IldusV/lighting_controller/README.md

# Lighting Controller Project

This project controls lights via Mqtt

## Preview

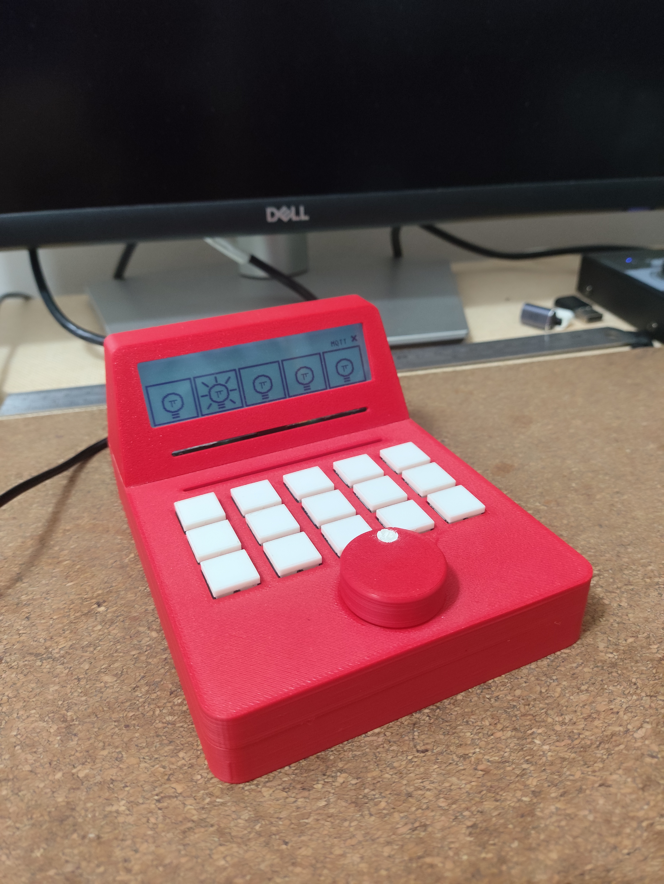
[picture p1: Documents/lighting_controller.jpg]
Lighting Controller


---

## Description
