IldusV/lighting_controller/Documents/README.md

# Lighting Controller Project

This project controls lights via Mqtt

## Preview

Lighting Controller

---

## Description
