IldusV/lighting_controller/Documents/JLX25664G-580_I2C_display_interface_CN.png

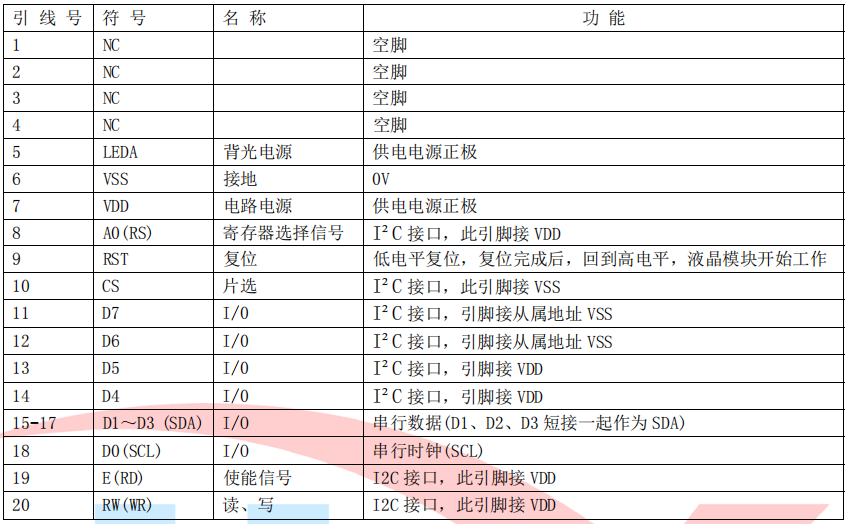
Documents/JLX25664G-580_I2C_display_interface_CN.png
