IldusV/lighting_controller/PCB/keypad/releases/lighting_keypad_schematic_rev_B.pdf

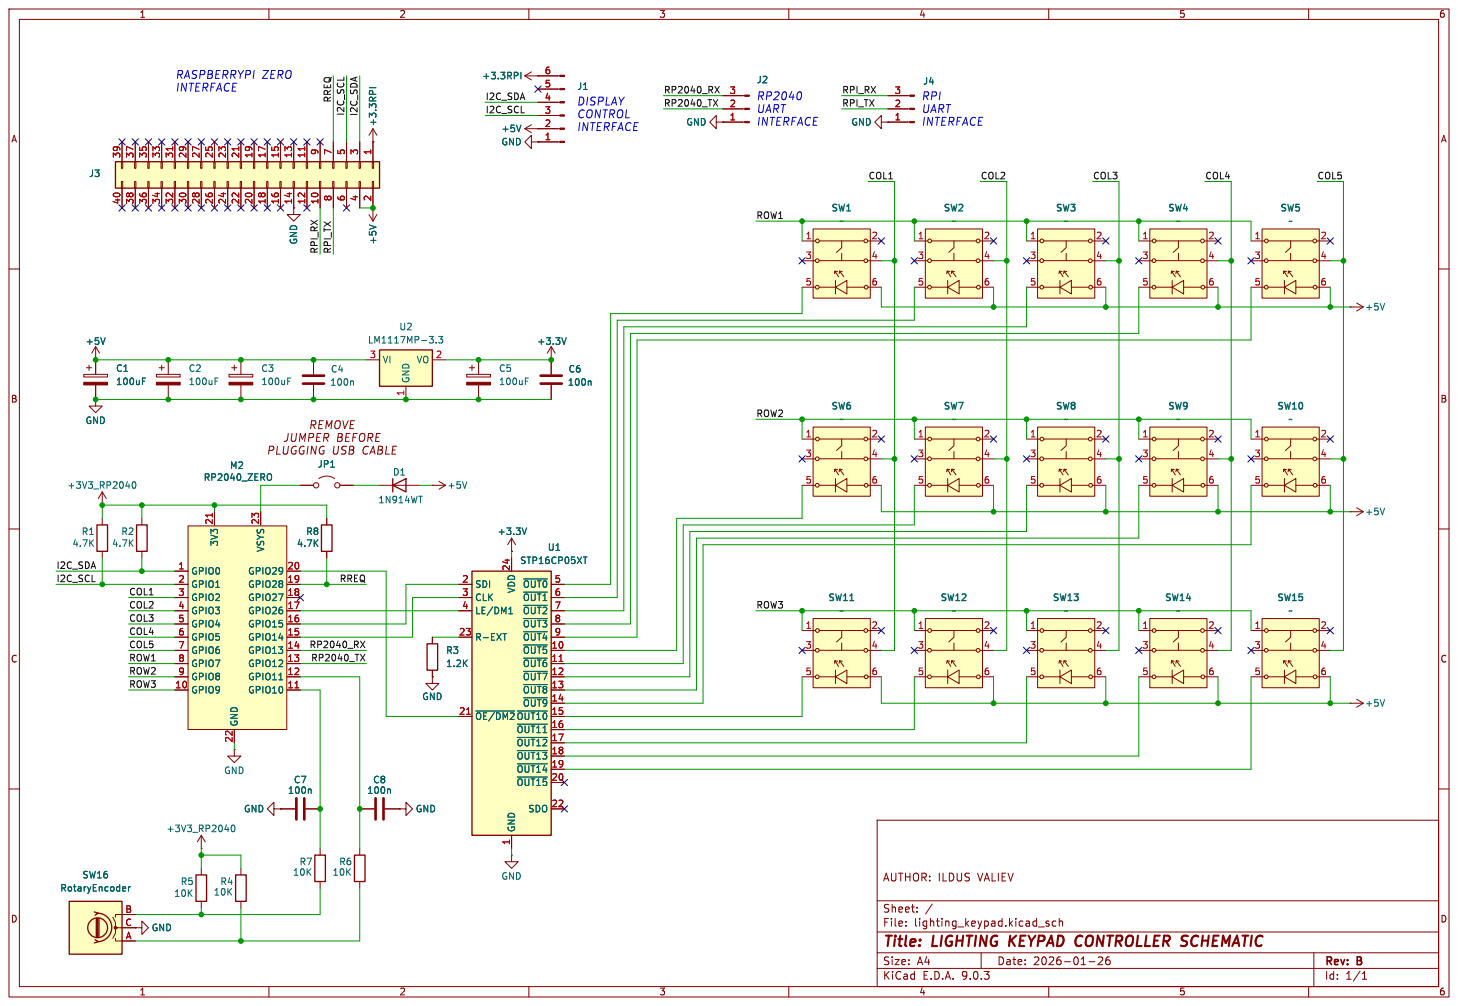
[picture p4: page 1]

File: lighting_keypad.kicad_sch Sheet: / AUTHOR: ILDUS VALIEV

Id: 1/1 Title: LIGHTING KEYPAD CONTROLLER SCHEMATIC
