IldusV/lighting_controller/PCB/keypad/lighting_keypad.kicad_pcb

## KiCad design PCB/keypad/lighting_keypad.kicad_pcb (2026-02-06)

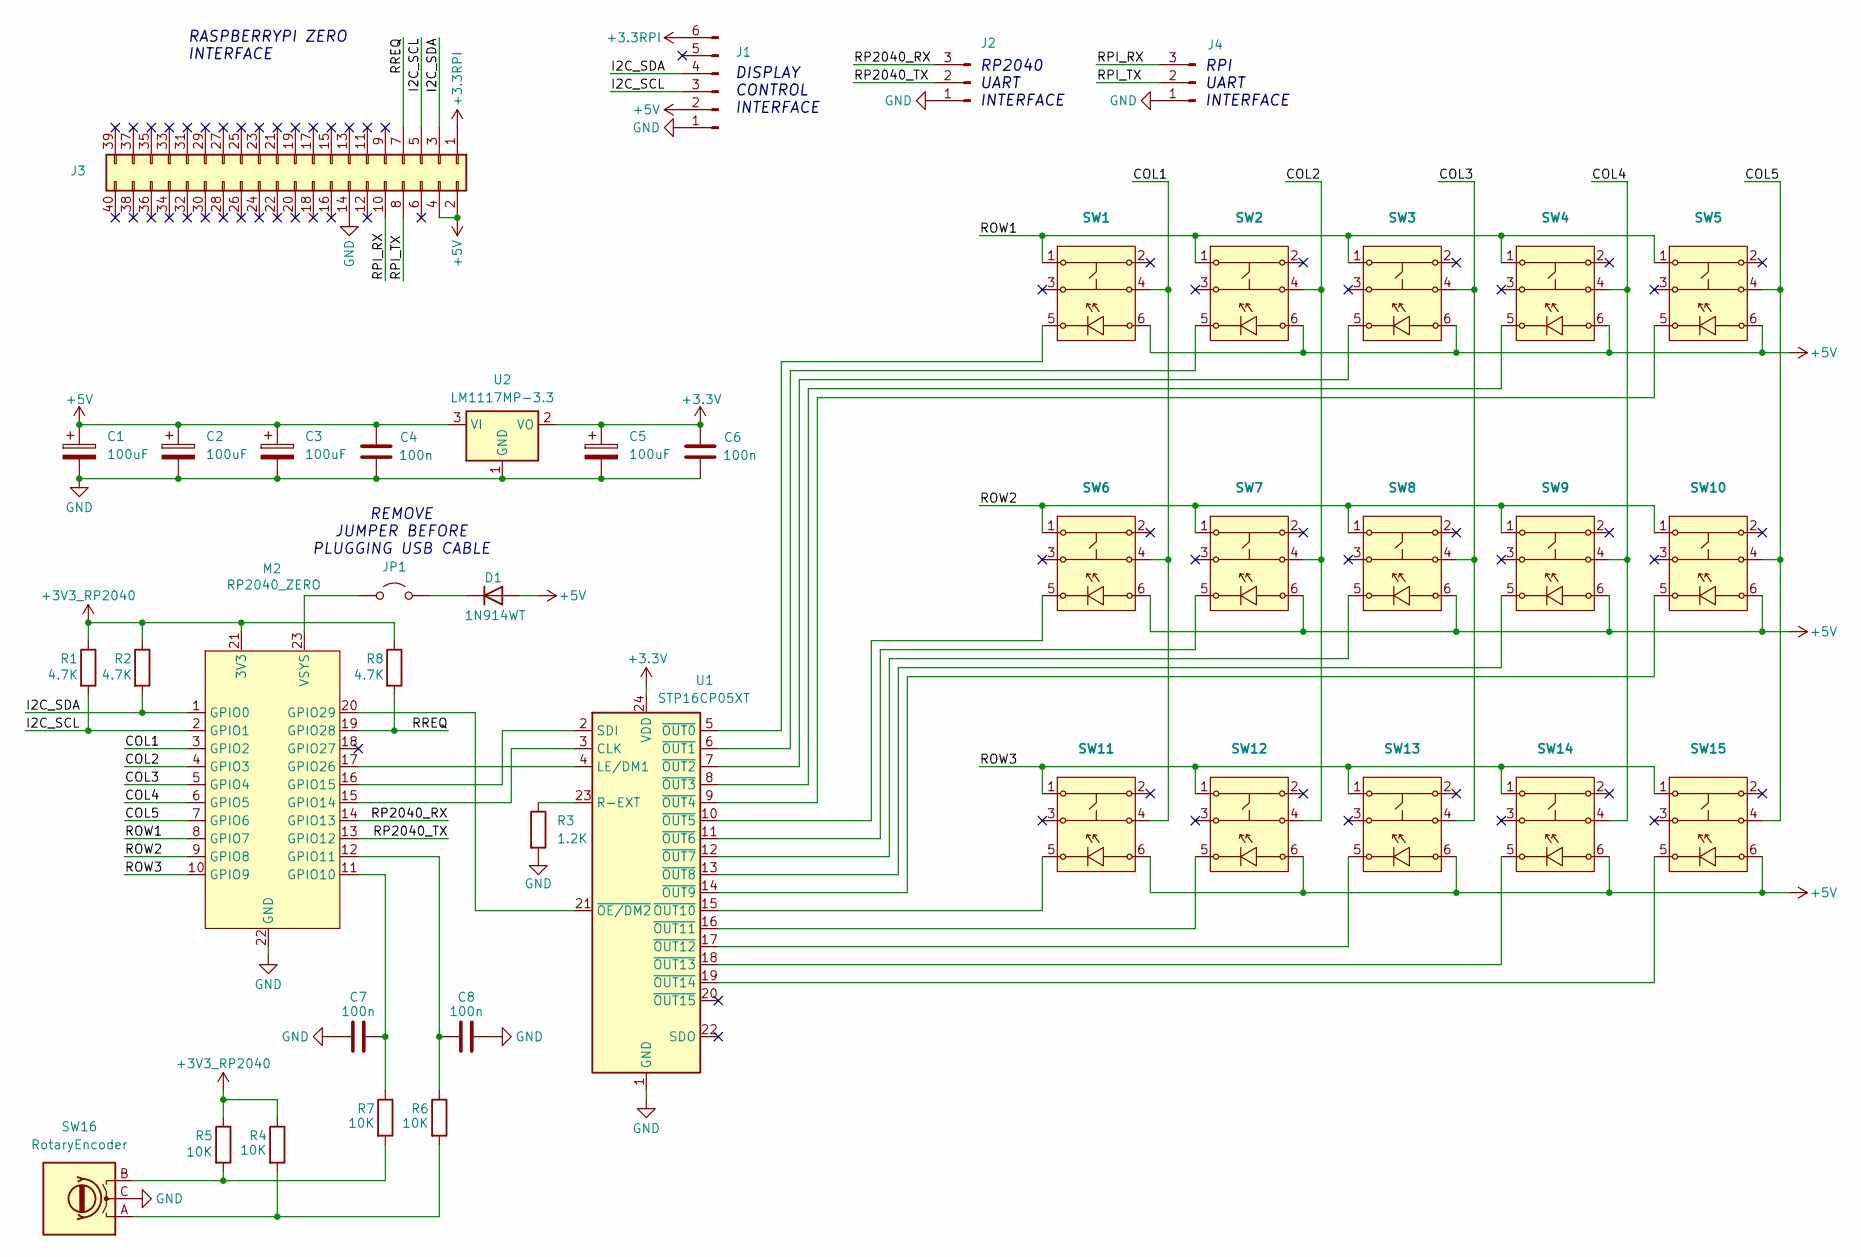
[picture p5: schematic lighting_keypad.kicad_sch, LIGHTING KEYPAD CONTROLLER SCHEMATIC]

Parts:
C1, C2, C3, C5: 100uF; CP_EIA-7343-30_AVX-N_Pad2.25x2.55mm_HandSolder
C4, C6, C7, C8: 100n; C_0603_1608Metric_Pad1.08x0.95mm_HandSolder
D1: 1N914WT; D_SOD-523
J1: Conn_01x06_Pin; PinHeader_1x06_P2.54mm_Vertical
J2, J4: Conn_01x03_Pin; PinHeader_1x03_P2.54mm_Vertical
J3: Conn_02x20_Odd_Even; raspberry_pi_zero_outline
JP1: Jumper_2_Open; PinHeader_1x02_P2.54mm_Vertical
M2: RP2040_ZERO; RP2040-Zero
R1, R2, R8: 4.7K; R_0603_1608Metric_Pad0.98x0.95mm_HandSolder
R3: 1.2K; R_0603_1608Metric_Pad0.98x0.95mm_HandSolder
R4, R5, R6, R7: 10K; R_0603_1608Metric_Pad0.98x0.95mm_HandSolder
SW1, SW2, SW3, SW4, SW5, SW6, SW7, SW8, SW9, SW10, SW11, SW12, SW13, SW14, SW15: Honyone_TS12
SW16: RotaryEncoder; RotaryEncoder_Alps_EC12E_Vertical_H20mm_CircularMountingHol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
U1: STP16CP05XT; SOIC127P1032X265-24N
U2: LM1117MP-3.3; SOT-223-3_TabPin2

Connections:
+3.3RPI: J1.6, J3.1
+3.3V: C5.1, C6.1, U1.24 (VDD), U2.2 (VO)
+3V3_RP2040: M2.21 (3V3), R1.1, R2.1, R4.1, R5.1, R8.1
+5V: C1.1, C2.1, C3.1, C4.1, D1.2 (A), J1.2, J3.2, J3.4, SW1.6, SW2.6, SW3.6, SW4.6, SW5.6, SW6.6, SW7.6, SW8.6, SW9.6, SW10.6, SW11.6, SW12.6, SW13.6, SW14.6, SW15.6, U2.3 (VI)
/COL1: M2.3 (GPIO2), SW1.4, SW6.4, SW11.4
/COL2: M2.4 (GPIO3), SW2.4, SW7.4, SW12.4
/COL3: M2.5 (GPIO4), SW3.4, SW8.4, SW13.4
/COL4: M2.6 (GPIO5), SW4.4, SW9.4, SW14.4
/COL5: M2.7 (GPIO6), SW5.4, SW10.4, SW15.4
/I2C_SCL: J1.3, J3.5, M2.2 (GPIO1), R1.2
/I2C_SDA: J1.4, J3.3, M2.1 (GPIO0), R2.2
/ROW1: M2.8 (GPIO7), SW1.1, SW2.1, SW3.1, SW4.1, SW5.1
/ROW2: M2.9 (GPIO8), SW6.1, SW7.1, SW8.1, SW9.1, SW10.1
/ROW3: M2.10 (GPIO9), SW11.1, SW12.1, SW13.1, SW14.1, SW15.1
/RP2040_RX: J2.3, M2.14 (GPIO13)
/RP2040_TX: J2.2, M2.13 (GPIO12)
/RPI_RX: J3.10, J4.3
/RPI_TX: J3.8, J4.2
/RREQ: J3.7, M2.19 (GPIO28), R8.2
GND: C1.2, C2.2, C3.2, C4.2, C5.2, C6.2, C7.2, C8.1, J1.1, J2.1, J3.14, J4.1, M2.22 (GND), R3.2, SW16.C, U1.1 (GND), U1.25 (GND), U2.1 (GND)
unnamed: D1.1 (K), JP1.2 (B)
unnamed: JP1.1 (A), M2.23 (VSYS)
unnamed: C7.1, M2.11 (GPIO10), R7.1
unnamed: C8.2, M2.12 (GPIO11), R6.1
unnamed: M2.15 (GPIO14), U1.3 (CLK)
unnamed: M2.16 (GPIO15), U1.2 (SDI)
unnamed: M2.17 (GPIO26), U1.4 (LE/DM1)
unnamed: M2.20 (GPIO29), U1.21 (~OE/DM2)
unnamed: R4.2, R6.2, SW16.A
unnamed: R5.2, R7.2, SW16.B
unnamed: R3.1, U1.23 (R-EXT)
unnamed: SW1.5, U1.5 (~OUT0)
unnamed: SW2.5, U1.6 (~OUT1)
unnamed: SW3.5, U1.7 (~OUT2)
unnamed: SW4.5, U1.8 (~OUT3)
unnamed: SW5.5, U1.9 (~OUT4)
unnamed: SW6.5, U1.10 (~OUT5)
unnamed: SW7.5, U1.11 (~OUT6)
unnamed: SW8.5, U1.12 (~OUT7)
unnamed: SW9.5, U1.13 (~OUT8)
unnamed: SW10.5, U1.14 (~OUT9)
unnamed: SW11.5, U1.15 (~OUT10)
unnamed: SW12.5, U1.16 (~OUT11)
unnamed: SW13.5, U1.17 (~OUT12)
unnamed: SW14.5, U1.18 (~OUT13)
unnamed: SW15.5, U1.19 (~OUT14)

Notes on the sheet:
DISPLAY CONTROL INTERFACE
REMOVE JUMPER BEFORE PLUGGING USB CABLE
RPI UART INTERFACE
RP2040 UART INTERFACE
RASPBERRYPI ZERO INTERFACE

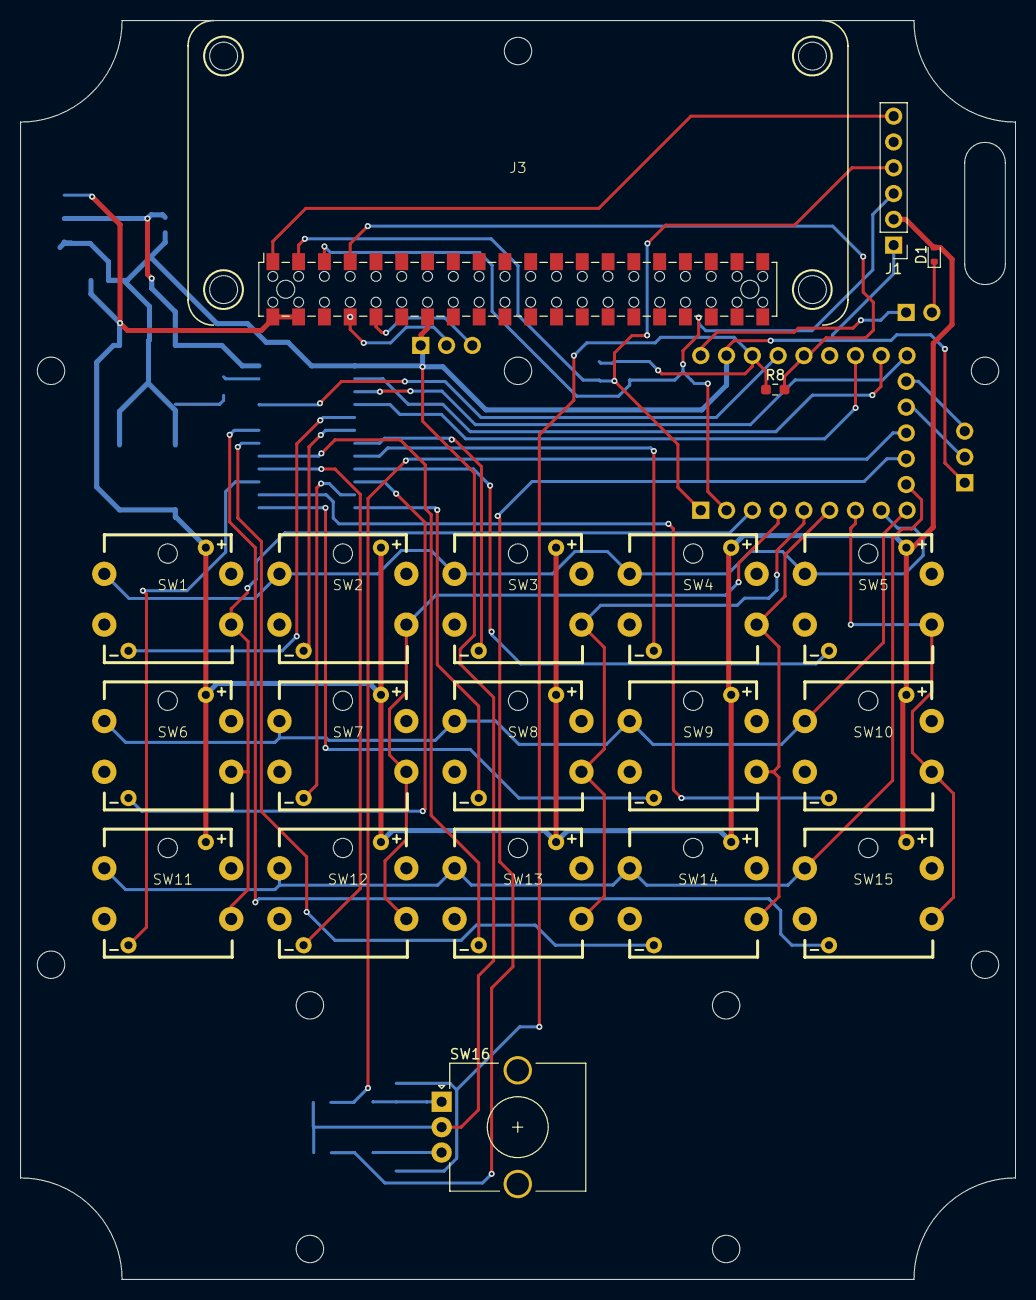
[picture p6: board lighting_keypad.kicad_pcb from above]

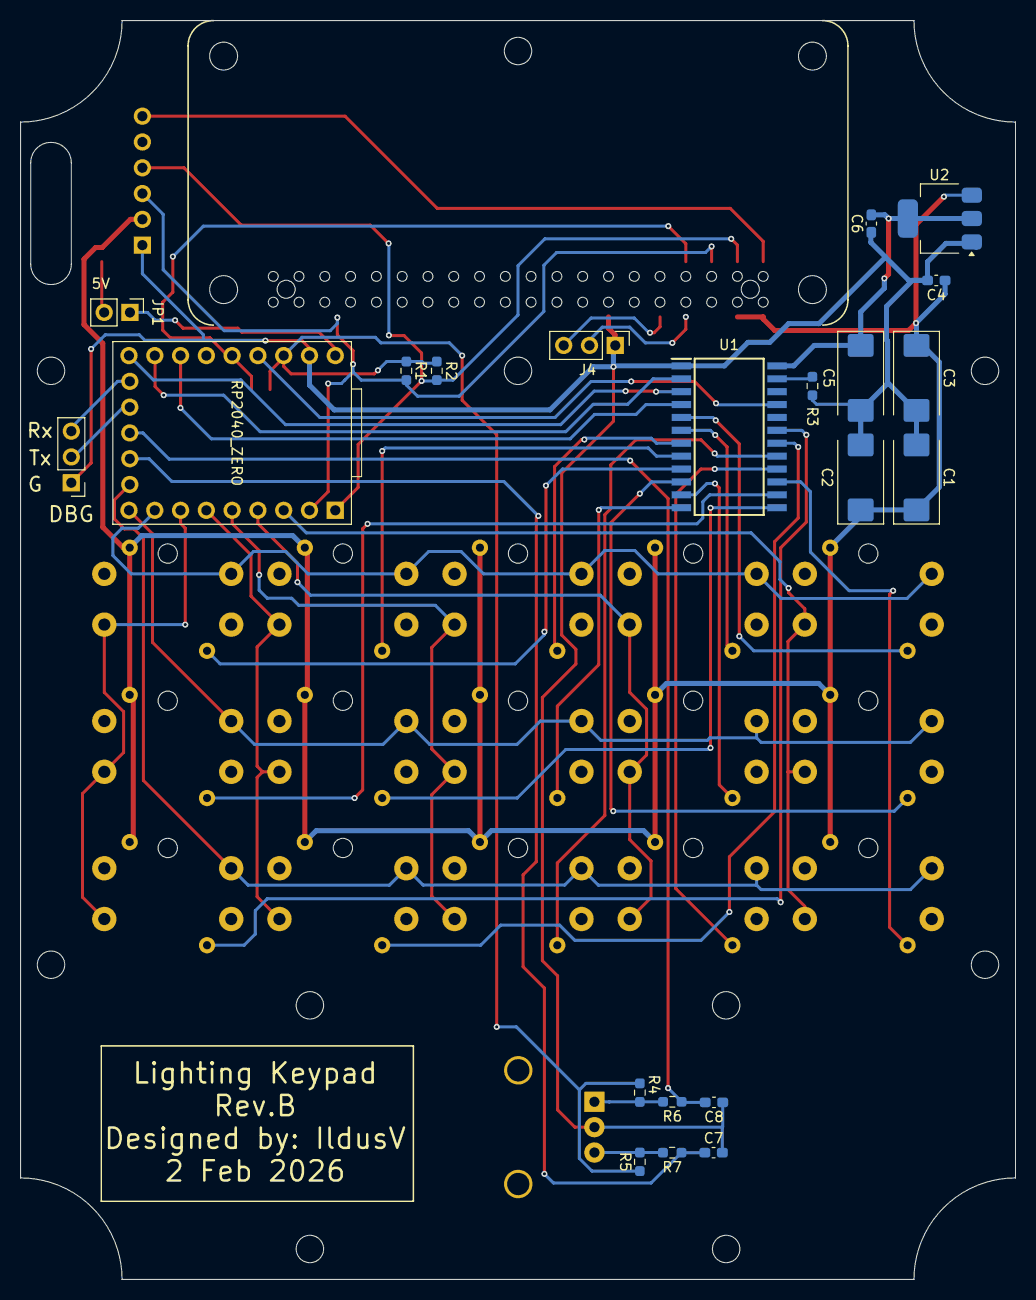
[picture p7: board lighting_keypad.kicad_pcb from below]

Board: 2 copper layers, 98.0 x 124.0 mm, 51 parts (21 on the bottom side), 46 nets.

Other parts of the board:
MH1, MH2, MH3, MH4, MH5, MH6, MH7, MH8, MH9, MH10: MountingHole_2.7mm_M2.5
