IldusV/lighting_controller/(commit log)

2025-02-23 Completed Rev.A
    [lighting_keypad.kicad_pcb, lighting_keypad.kicad_sch]
2026-02-06 Completed Rev.B
    [lighting_keypad.kicad_pcb, lighting_keypad.kicad_sch]
2026-02-07 Add remaining files
    [SSH OVER USB CONFIGURATION.txt, lighting_keypad.kicad_pcb, lighting_keypad.kicad_sch]
2026-02-14 added jlx25664 support via i2c
2026-02-18 modularized I2C & keypad driver
2026-03-08 Added: - Actuator status conatainer - Command manager to handle commands from keypad and status messages from MQTT - Event based handling
2026-03-27 Enhanced U8G2Driver to take i2c object, fixes #8
    [DisplayRenderer.cpp, main.cpp]
2026-03-29 Added WiFi connection state updates to main, fixes #22
    [DisplayRenderer.cpp, SystemState.h, WiFiWatcher.cpp, WiFiWatcher.h, main.cpp]
2026-03-29 Added Mqtt SystemStatus updates and rendering, fixes #23
    [DisplayRenderer.cpp, MqttMgr.cpp, MqttMgr.h, SystemState.h, WiFiWatcher.cpp, main.cpp]
2026-03-30 Added queueing for mqtt messages, fixes #25
    [MqttEventQueue.h, main.cpp]
2026-04-02 Added queueing of the button events, fixes #24
    [ButtonEventQueue.h, main.cpp]
2026-04-06 Implemented button LED handling, fixes #15
    [ActuatorState.h, CommandManager.cpp, KeypadDriver.cpp, KeypadDriver.h, main.c, main.cpp]
